Herons-0/Project-O.A.S.I.S/images/Front_View.jpeg

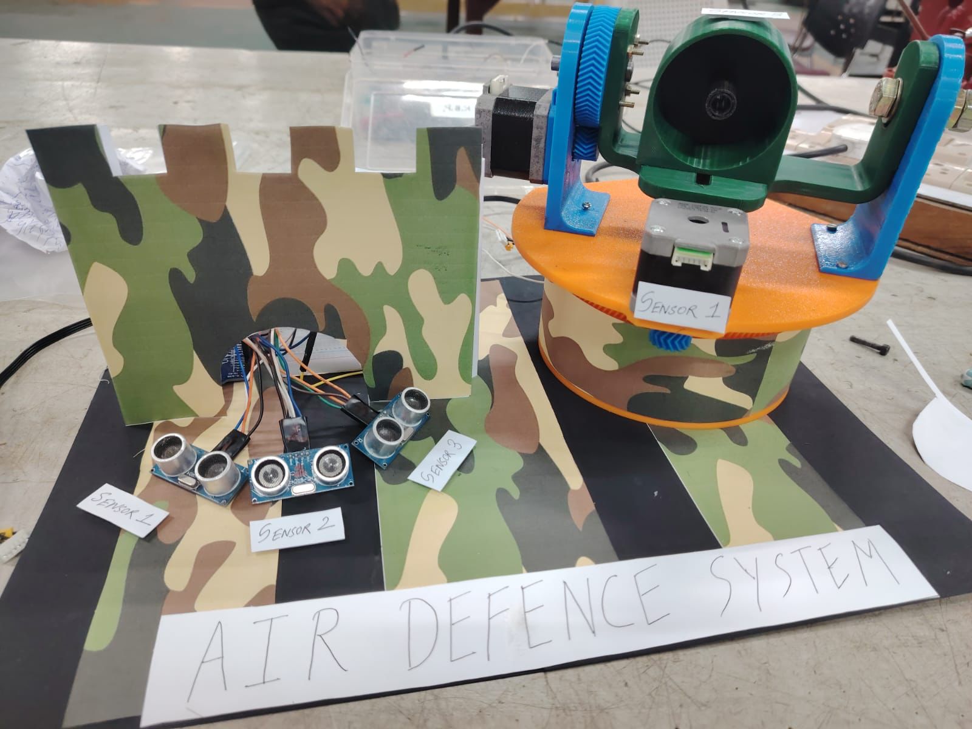
images/Front_View.jpeg
