Herons-0/Project-O.A.S.I.S/images/Final Image.jpeg

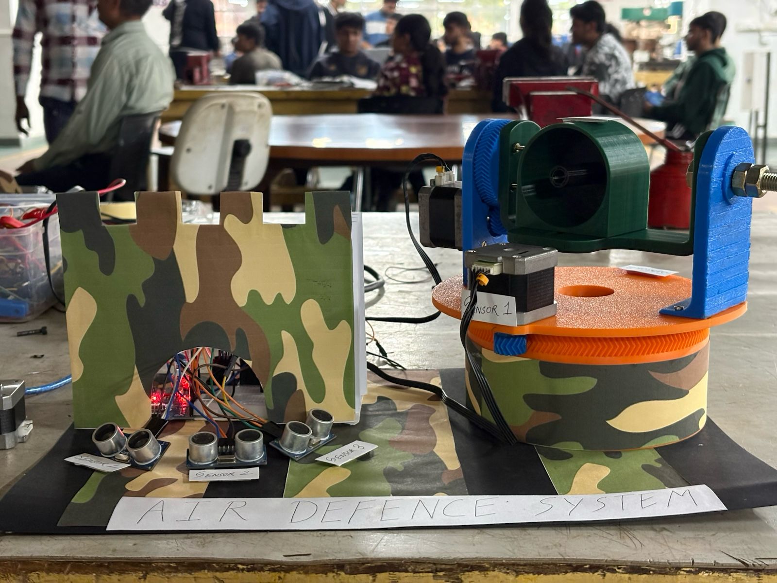
images/Final Image.jpeg
