Herons-0/Project-O.A.S.I.S/O.A.S.I.S_Overall_Report.pdf

## TA212: Manufacturing Processes – II

1

### st Semester 2025–26

# Project Report

on

# AIR DEFENCE SYSTEM

## Group No: 5

## Group Members

1. Trisha Bafna | Roll No: 241104
2. Abhinav Mishra | Roll No: 240035
3. B Utham Teja Sree | Roll No: 240280
4. Ritika Batra | Roll No: 240876
5. Samay | Roll No: 240919
6. Ashwin Kumar Singh Roll No: 240219
7. Yagnik Parmar | Roll No: 241191
8. Trisha Shekhawat | Roll No: 241105

Guide: Mr. Kishan Prajapati

Tutor: Mr. Amit Choudhary

Lab I/c.: Aman Singh

Course Instructor: Dr. Sarvesh Mishra

Indian Institute of Technology, Kanpur

## TA212: Manufacturing Processes – II

1

### st Semester 2025–26

# Project Report

on

# AIR DEFENCE SYSTEM

## Group No: 5

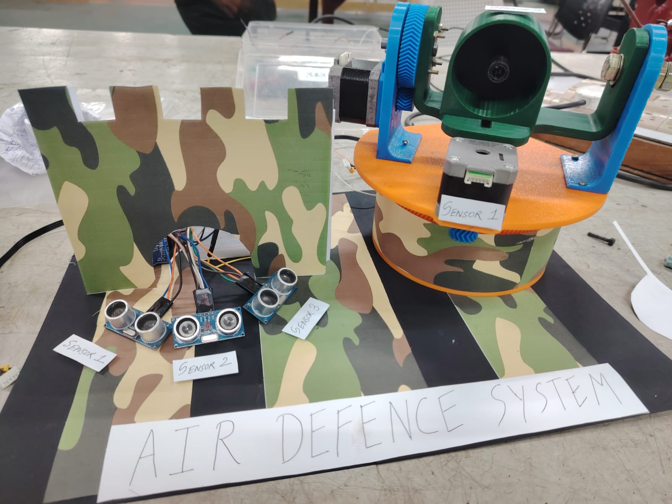
[picture p3: figure]

Guide: Mr. Kishan Prajapati Tutor: Mr. Amit Choudhary
Lab I/c.: Aman Singh | Course Instructor: Dr. Sarvesh Mishra

Indian Institute of Technology, Kanpur

# Isometric Drawing

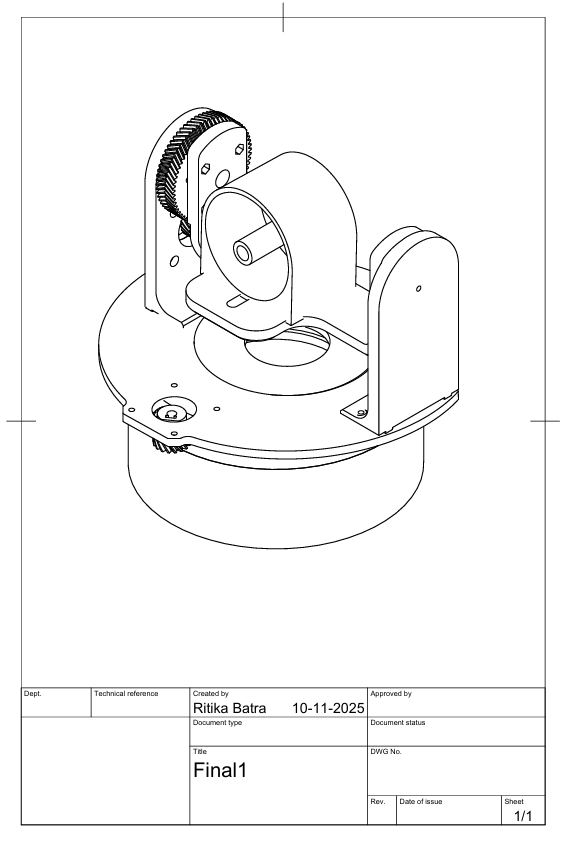
[picture p4: figure]

# INDEX

1. Individual Parts’ Information
2. All Components’ Part Drawings
3. Project Overview

3.a) Introduction

3.b) Objectives

3.c) System Components

3.d) Working Principle

3.e) Control Flow

4. Acknowledgement
5. Abstract
6. Motivation
7. Motor Sizing: Torque Requirement Calculation
8. Students’ Log Sheets
9. Cost Estimation

# Individual Parts’ Information

Part Name | Material Used | Quantity
64 Teeth Herringbone | 3D Printed | 1
21 Teeth Herringbone | 3D Printed | 1
Bolt Spacer | 3D Printed | 1
Base Mount Bearing Clip Ring | 3D Printed | 1
Hall Effect Stepper Mount | 3D Printed | 1
Pan Mount | 3D Printed | 1
Idle Side Support | 3D Printed | 1
144 Teeth Herringbone Mount | 3D Printed | 1
17 Teeth Herringbone Gear | 3D Printed | 1
Gear Side Support | 3D Printed | 1
Trigger | 3D Printed | 1
Trigger Aligner | 3D Printed | 1
Pivot Support/Supporting Workpiece | Mild Steel | 1

# All Components’ Part Drawings

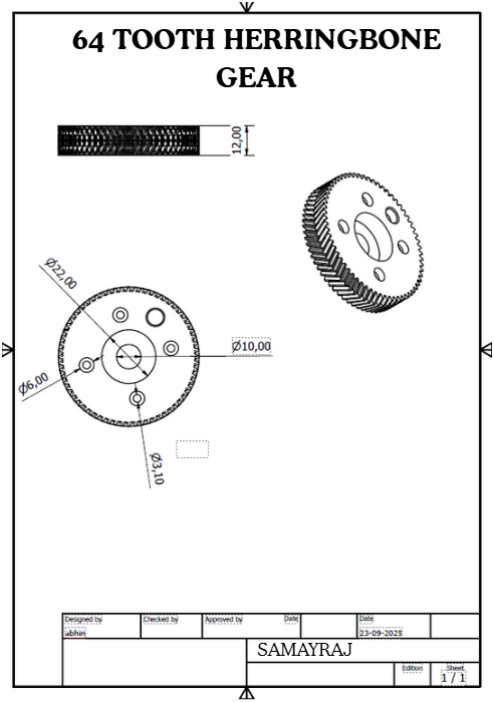
[picture p5: figure]

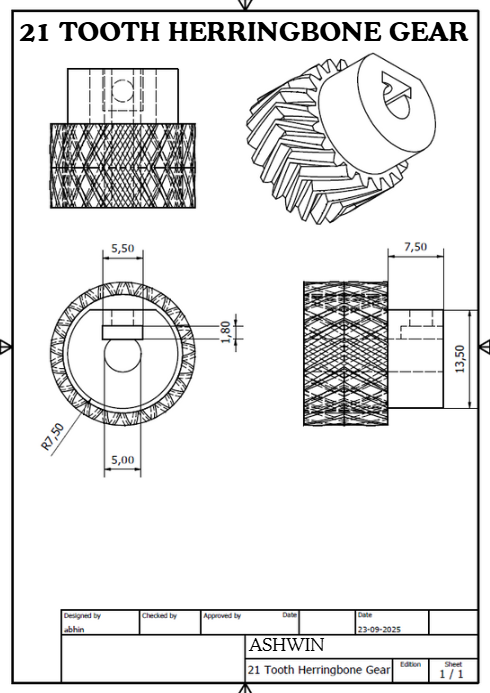
[picture p6: figure]

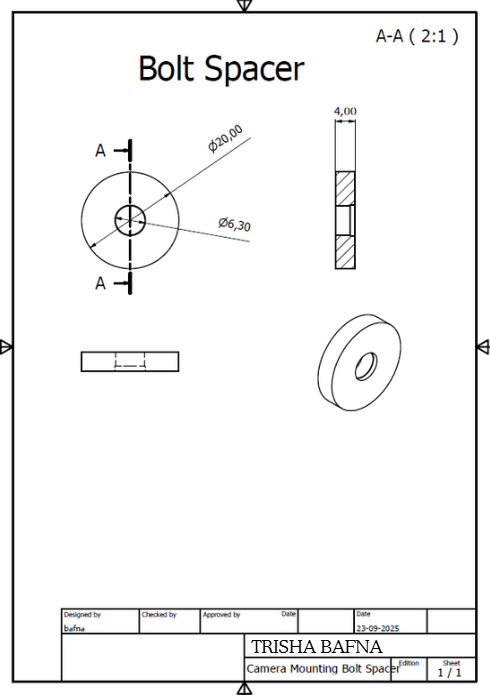
[picture p7: figure]

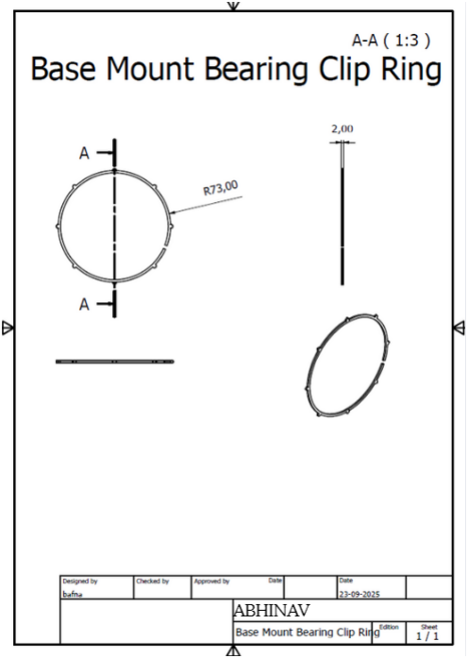
[picture p8: figure]

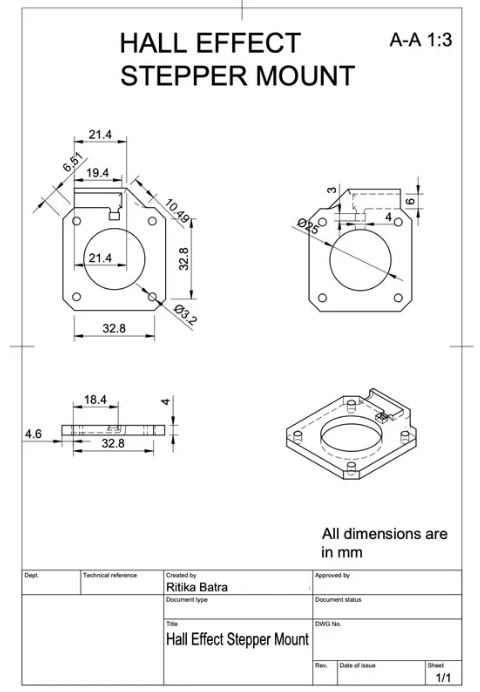
[picture p9: figure]

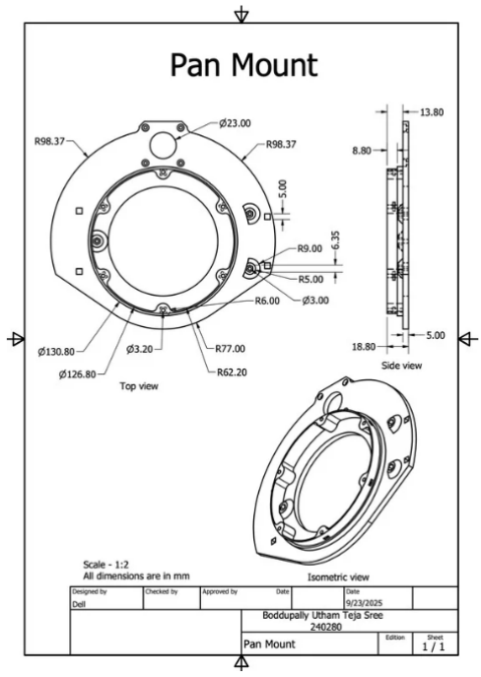
[picture p10: figure]

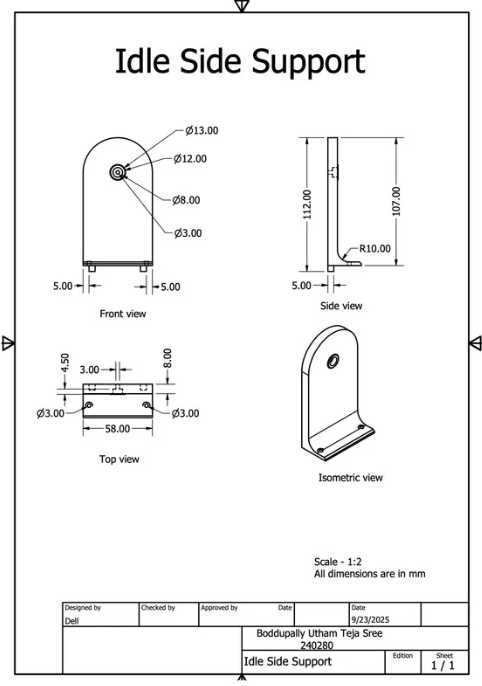
[picture p11: figure]

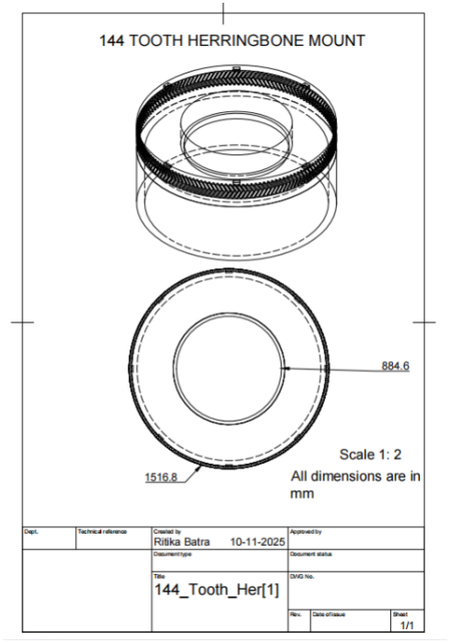
[picture p12: figure]

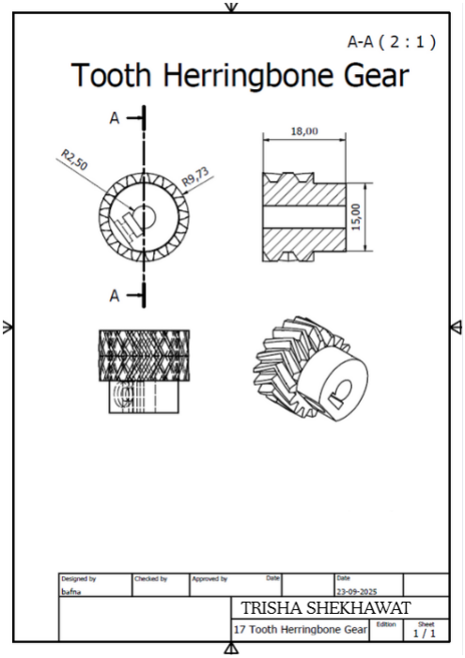
[picture p13: figure]

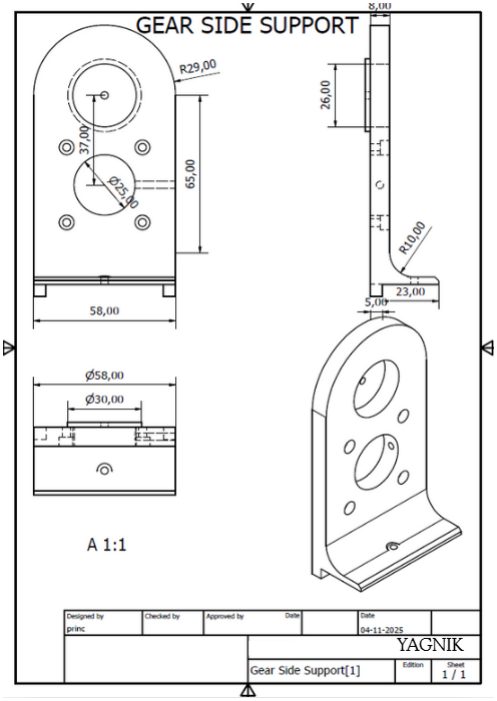
[picture p14: figure]

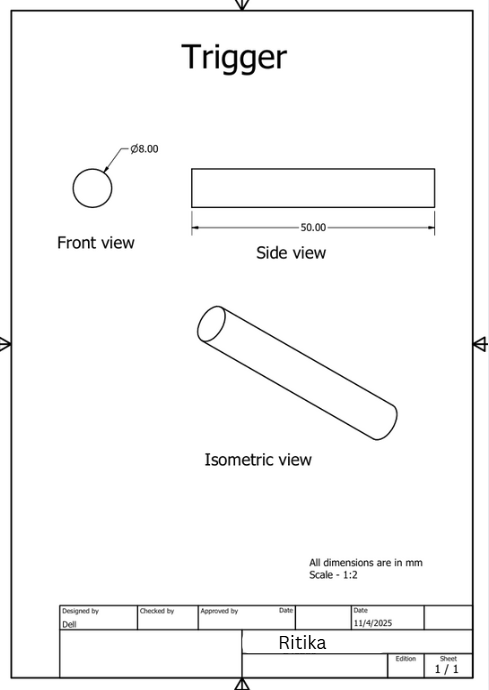
[picture p15: figure]

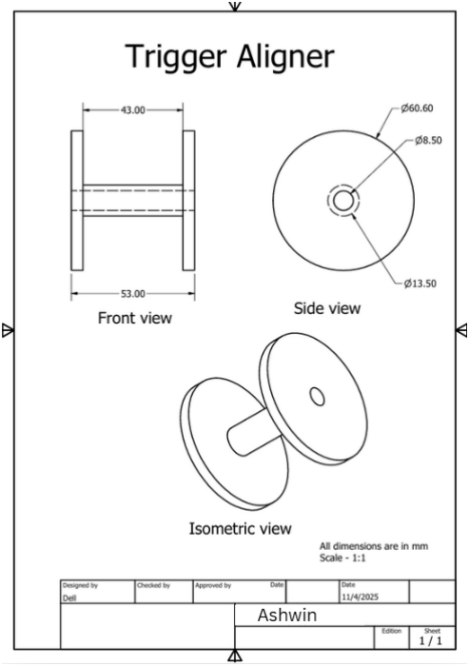
[picture p16: figure]
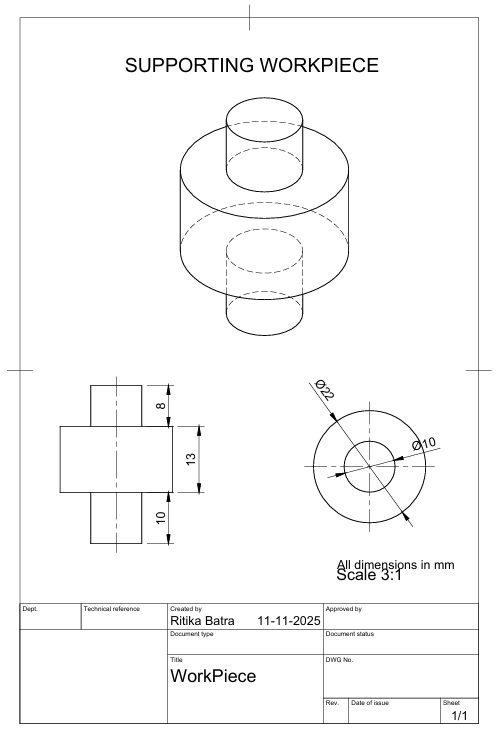
[picture p17: page 19]

# Project Overview

## 1. Introduction

### The project aims to design and develop an automated air defense mechanism capable of detecting, tracking, and neutralizing a target

within a specified range. The system integrates ultrasonic sensors,

### stepper motors, and a mechanical firing actuator, all coordinated through an Arduino microcontroller. This prototype demonstrates how sensor-based detection and automated targeting systems can be used in

defense and surveillance applications.

## 2. Objectives

a) To detect an approaching object using ultrasonic sensors.
b) To calculate the relative position (distance/coordinates) of the detected object.
c) To orient the turret automatically toward the target using two-axis stepper motor

control.

d) To launch a projectile using an mechanical firing actuator once the target is

aligned.

e) To demonstrate a low-cost automated defense system for small-scale

demonstration or educational use.

## 2. System Components

1. Ultrasonic Sensors (3 units):
- One placed on the system.
- One on tilt mechanism.
- One on pan mechanism.
- Used to detect the distance of the target and estimate its position in 3D

space.

2. Arudino Microcontroller (Arduino UNO):
- Acts as the brain of the system.
- Processes sensor data and controls the rotation and firing mechanisms.
3. Stepper Motors (2 units):
- One controls horizontal rotation (Y-axis).
- One controls vertical tilt (Z-axis).
- Provides precise positioning of the turret.
4. Power Supply:
- Provides sufficient current to the motors.
- Usually consists of separate regulated supplies for control and power circuits.
5. Driver Modules:
- Motor Driver (DRV8255): Controls stepper motor movement.

## 4. Working Principle

1. Detection:

The ultrasonic sensors continuously emit and receive sound waves to measure

distances and detect the object.

2. Position Calculation:

We have a system of 3 ultrasonic sensors continuously rotating. When an object is

detected in any of them, the degree to which the motors have to move is

calibrated by the code.

3. Targeting:

The Arduino sends control signals to the two stepper motors, rotating the turret

to align with the detected coordinates.

4. Firing Mechanism:

Once aligned, the Arduino stops the turret in the target’s direction. The firing is

then done manually by the operator using a mechanical trigger to launch the

projectile.

## 5. Control Flow

Ultrasonic Detection
↓

Degree Calculation
↓

Coordinate Estimation
↓

Stepper Motor Alignment
↓

Firing

# Acknowlegement

We would like to express our sincere gratitude to our guide, Mr. Kishan Prajapati sir, for his continuous support, valuable guidance and encouragement throughout this project. We also thank our department faculty and laboratory staff for providing the facilities and resources necessary to complete this work. Finally, we extend our appreciation to our teammates for their cooperation, ideas and teamwork in developing

our Automated Air Defence Mechanism project.

# Abstract

This project presents the design and development of an Automated Air Defence Mechanism capable of detecting, tracking and firing at a target automatically. The system uses three ultrasonic sensors placed on the system that keep rotating continously and detect static objects. Based on the calculated degrees, two stepper motors rotate the turret along the Y and Z axes to align with the target. Once aligned, a mechanical firing mechanism launches an aluminium projectile toward the target. The

prototype demonstrates the integration of sensor-based detection, automated motion control, and actuation for defense applications,

### providing a foundation for future advancements in autonomous targeting

systems.

# Motivation

### Our motivation behind this project is to design a simple, low-cost prototype that demonstrates the basic working principle of an air defence system — using Arduino, sensors and motors to detect an approaching

object and automatically aim or respond.

Through this project, we aimed to:

- Understand how sensors can detect motion or objects in real-time.
- Learn how Arduino can control motors to simulate target tracking.

### - Explore the integration of hardware and programming to create an

automated defence mechanism.

- Develop an interest in defence technology and robotics applications.

### Ultimately, our goal was to create a miniaturized demonstration of an intelligent air defence system, showcasing how automation and embedded

systems can play a vital role in national security.

# Motor Sizing: Motor torque requirement calculation

Calculation based on provided data and general assumptions

# I. Tilt Motor

## 1. Given Data and Assumptions

This calculation is based on the data provided and the following general assumptions

for missing values.

- mload = 70.11 kg = 0.07191 kg | (Load mass)
- mgear = 15 g = 0.015 kg | (Driven gear mass)
- R1 = 7.5 mm = 0.0075 m | (Driving gear radius)
- R2 = 11.5 mm = 0.0115 m | (Driven gear radius)
- dsg = 2.25 cm = 0.025 m | (Assumed C.G. distance)
- µ = 0.35 | (Assumed friction coeff. PLA-PLA)
- Raxle = 5 mm = 0.005 m | (Assumed axle radius)
- V = 60 rpm | (Assumed operating speed)
- tg = 1.0 | (Assumed gear ratio)
- FOS = 2.0 | (Factor of Safety, from PDF)
- g = 9.81 m/s²
(Gravitational acceleration)

## 2. Step-by-Step Calculation

The total torque required from the motor is the sum of the load, friction, and

acceleration torques, all reflected back to the motor via the gear ratio and multiplied by a Factor of Safety (FOS).

Ttotal = (TL + TF + TA) × FOS

### 2.1 Gear Ratio (i)

The gear ratio (i) reflects the torque from the load shaft back to the motor shaft.

i =

R2
R1

=

0.0075 m
0.0115 m

= 0.652

### 2.2 Load Torque (TL) (due to Gravity)

First, calculate the force and torque at the load’s arm.

FL = mload × g = 0.07191 kg × 9.81 m/s² = 0.776 N

TL,load = FL × dsg = 0.776 N × 0.025 m = 0.0194 Nm

Next, reflect this torque back to the motor.

TL = TL,load × i = 0.0194 Nm × 0.652 = 0.0126 Nm

### 2.3 Friction Torque (Tf )

First, find the total normal force (FN ) from the combined weight of the load and the

driven gear.

mtotal = mload + mgear = 0.07191 kg + 0.015 kg = 0.09411 kg

FN = mtotal × g = 0.09411 kg × 9.81 m/s² = 0.923 N

Next, find the friction torque at the axle.

Tf,load = (FN × µ) × Raxle = (0.35 × 0.923 N) × 0.005 m = 0.0016 Nm

Finally, reflect this torque back to the motor.

Tf = Tf,load × i = 0.0016 Nm × 0.652 = 0.0010 Nm

### 2.4 Acceleration Torque (Ta)

The acceleration torque is based on the total reflected inertia (Jtotal) and the formula

from the lecture PDF.

Jtotal = 2.83 × 10⁻⁵

kg·m
2
(Calculated inertia reflected to motor)

Ta =

Jtotal × V
9.55 × ta

=

(2.83 × 10⁻⁵ kg·m
2
) × (60 rpm)
9.55 × 1.0 s

Ta = 0.00018 Nm (This value is negligible)

## 3. Total Required Torque (Ttotal)

Sum the components and apply the Factor of Safety.

Ttotal = (TL + Tf + Ta) × FOS

Ttotal = (0.0126 + 0.0010 + 0.00018) Nm × 2.0

Ttotal = (0.01378 Nm) × 2.0

Ttotal = 0.0276 Nm

## Conclusion

The total estimated torque required from the motor is 0.0276 Nm (or 2.76 N·cm). This

is well within the typical holding torque capacity of a standard NEMA 17 motor.

# II. Pan Motor

## 1. Given Data and Assumptions

This calculation is for the bottom motor rotating the entire upper assembly (modeled as

an “Index Table”).

- m = 634 g = 0.634 kg | (Total rotating mass)
- R = 63 mm = 0.063 m | (Radius of assembly, as a disc)
- µ = 0.3 | (Assumed bearing friction coeff.)

- Raxle = 5 mm = 0.005 m | (Assumed bearing axle radius)
- V = 60 rpm | (Assumed operating speed)
- ta = 1.0 s | (Assumed acceleration time)
- FOS = 2.0 | (Factor of Safety, from PDF)
- g = 9.81 m/s²
(Gravitational acceleration)

## 2. Step-by-Step Calculation

For a horizontally rotating table, the total torque is the sum of the friction torque and the acceleration torque, multiplied by a Factor of Safety (FOS). There is no load torque

due to gravity.

Ttotal = (Tf + Ta) × FOS

### 2.1 Friction Torque (Tf )

This is the torque required to overcome the friction in the central rotating bearing. First, calculate the Normal Force (FN ) from the total weight of the assembly.

FN = m × g = 0.634 kg × 9.81 m/s² = 6.22 N

Next, find the friction torque at the bearing.

Tf = (µ × FN ) × Raxle = (0.3 × 6.22 N) × 0.005 m

Tf = 0.0093 Nm

### 2.2 Acceleration Torque (Ta)

This is the torque required to accelerate the assembly from rest to its operating speed. First, calculate the Moment of Inertia (Jd) for the assembly, modeling it as a solid disc

(as per the PDF’s “Index Table” example).

Jd =

1
2

mR² = 0.5 × (0.634 kg) × (0.063 m)²

Jd = 0.00126 kg·m
2

Next, use the formula from the lecture PDF to find the acceleration torque.

Ta =

Jd × V
9.55 × ta

=

(0.00126 kg·m
2
) × (60 rpm)
9.55 × 1.0 s

Ta = 0.0079 Nm

## 3. Total Required Torque (TTotal)

Sum the components and apply the Factor of Safety.

T Total = (T F + T R) × FOS

T Total = (0.0035 Nm + 0.0079 Nm) × 2.0

T Total = (0.0172 Nm) × 2.0

T Total = 0.0344 Nm

Conclusion: The total estimated torque required from the bottom motor is 0.0344 Nm (or 3.44 mNm). This is well within the typical holding torque capacity of a standard

NEMA 17 motor.

# Cost Estimation

## Costs Given:

### Material Cost (/ Kg):

- Mild Steel : Rs. 90
- Nuts and Bolts : Rs. 130
- Clips and Fold : Rs. 120

### Machine Usage Cost (/ Hrs.):

- 3D Printing : Rs. 300
- Lathe : Rs. 350
- Milling : Rs. 450
- Drilling : Rs. 100
- Cutting : Rs. 60

### Labour Cost (/Day or /8 Hrs.):

- Unskilled : Rs. 650
- Skilled : Rs. 850

### Cost of Electronics Kit:

- With single Motor : Rs. 2500
- With 2 Motors : Rs. 3000

## Material Weight

Mild Steel: 1 piece

Volume = π × 10 × 10 + π × 5 × 5 × 10 + π × 13 × 5 × 5

= π × 1375

= 4319.68 mm³

Density of Mild steel = 7850 kg/m³

Weight = Volume × Density

= 0.339 kg = 339 gm

Nuts and Bolts: 7 M2 + 2 M10 + 2 Big Nuts + 1Washer + 4 Nuts

7 × 5 gm + 2 × 12 gm + 2 × 4 gm + 1 × 2 gm + 4 × 1.3 gm = 74.2 gm

Clips and Fold: 0 kg

## Machine Usage Time

3D Printing: 3 × 3 + 2.5 × 2 + 2 × 1 = 16 hours

Lathe: 1 hour 15 min

Milling: 0 hours

Drilling: 30 mins

Cutting: 0 hours

## Labour Hours

Unskilled: 13 Labs + 2 × 10 + 1 × 8 = 13 × 3 + 2 × 10 + 1 × 8 = 67 Hours

## Electronics Kit

2 Motors used

## Material Cost

Mild Steel: Rs. 90 /Kg × 0.339 kg = Rs. 30.51

Nuts and Bolts: Rs. 130 /Kg × 0.0742 kg = Rs. 9.64

Clips and Fold: Rs. 0

## Machine Usage Time

3D Printing: Rs. 300 /Hrs. × 16 Hrs. = Rs. 4800

Lathe: Rs. 350 /Hrs. × 1.25 Hrs. = Rs. 437.5

Milling: Rs. 0

Drilling: Rs. 100 /Hrs. × 0.5 Hrs. = Rs. 50

Cutting: Rs. 0

## Labour Hours

Unskilled: Rs. 650 /8Hrs. × 67 Hrs. = Rs. 5443.75

## Electronics Kit

### 2 Motors used: Rs. 3000

Sensors: Rs. 960

Springs: Rs. 320

Driver: Rs. 560

Mosfets: Rs. 240

# Total : Rs. 15,831.4

# Thankyou - Jai Hind
