Herons-0/Project-O.A.S.I.S/(commit log)

2026-06-17 Final code to upload on Arduino UNO
2026-11-12 README: fix typos, remove the duplicated note, add upload steps
    - Fix spelling (developed, mechanism, constraint, capabilities, use case)
    and remove the course note that appeared twice.
    - Add how to upload the sketch (NewPing library, board, serial baud rate)
    and a table of what is in the repository.
    - Remove images/placeholder.txt, an empty upload placeholder.
    Claude-Session: https://claude.ai/code/session_015PQhucXvGS4et8W2Z7osG6
